mihaizh/triangulation/(commit log)

2018-04-26 Replace sensor with MPU6050 and move stepper on timer
    [sketch_position.ino]
2018-05-01 Add wiring image
